tlabcustomaudio/lm4250-replacement/LICENSING.md

# Licensing

| Part | Licence |
|---|---|
| Scripts (`sim/`) | MIT — see `LICENSE` |
| Text, tables, figures (`README.md`, `docs/`, `figures/`, `data/`) | CC BY 4.0 — https://creativecommons.org/licenses/by/4.0/ |
| Hardware (`hardware/`: KiCad schematic, PDF) | CERN-OHL-S-2.0 — https://ohwr.org/cern_ohl_s_v2.txt |

Third-party material (TI/National LM4250 datasheet and AN-71, HGSemi LM13700 datasheet) is not included; refer to the manufacturers.
