tlabcustomaudio/lm4250-replacement/hardware/clone/LM4250_CLONE-schematic.pdf

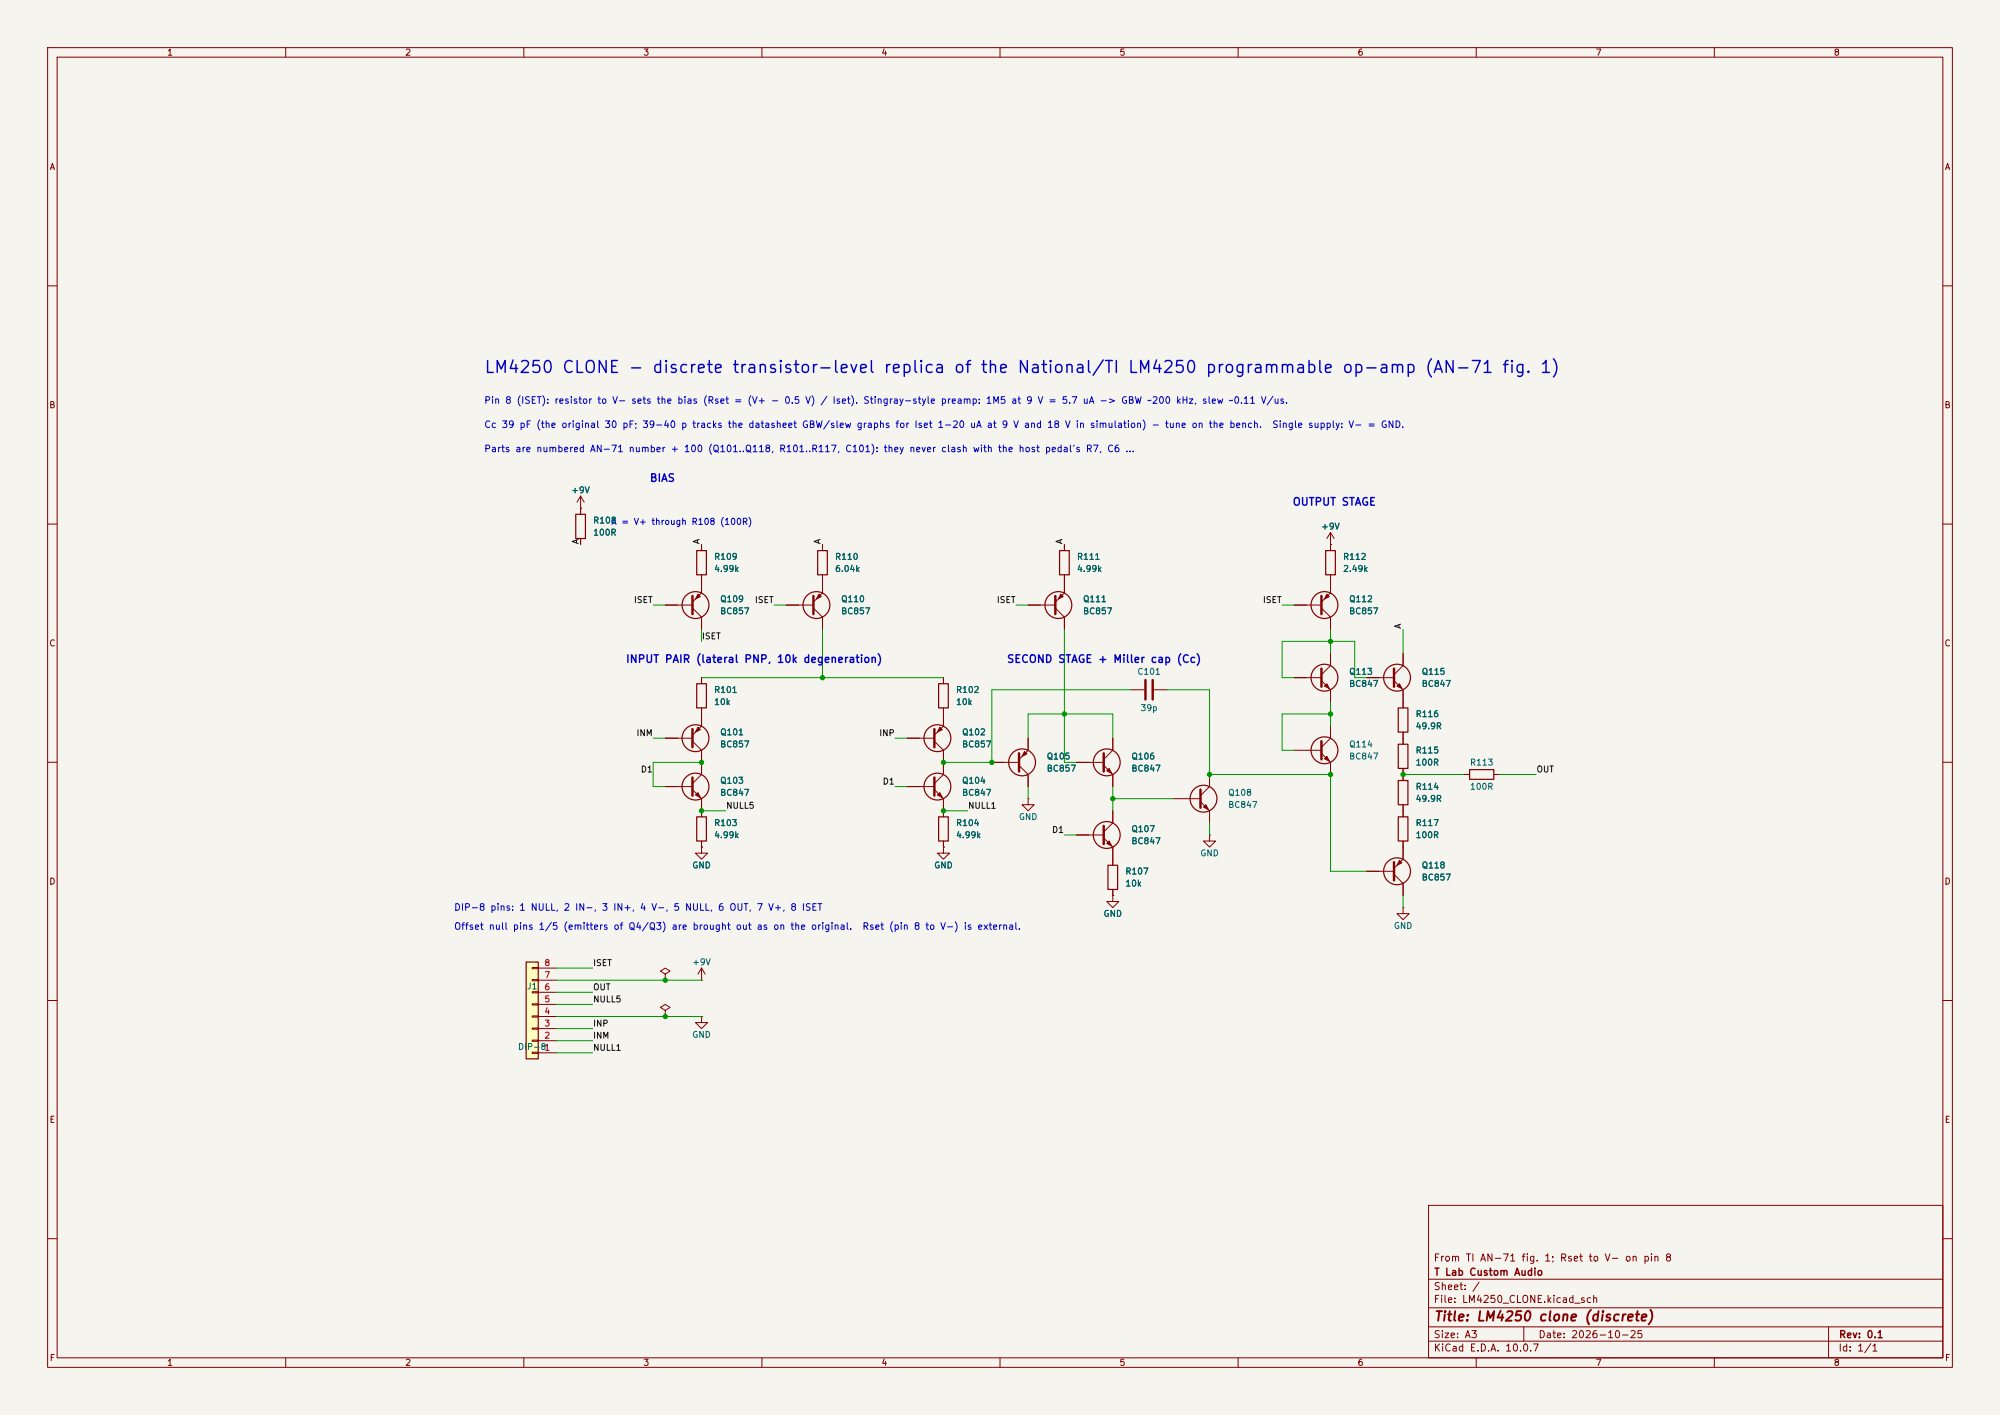
[picture p10: page 1]

LM4250 CLONE - discrete transistor-level replica of the National/TI LM4250 programmable op-amp (AN-71 fig. 1)

A = V+ through R108 (100R) Cc 39 pF (the original 30 pF; 39-40 p tracks the datasheet GBW/slew graphs for Iset 1-20 uA at 9 V and 18 V in simulation) - tune on the bench. Single supply: V- = GND. Parts are numbered AN-71 number + 100 (Q101..Q118, R101..R117, C101): they never clash with the host pedal's R7, C6 ... SECOND STAGE + Miller cap (Cc) Pin 8 (ISET): resistor to V- sets the bias (Rset = (V+ - 0.5 V) / Iset). Stingray-style preamp: 1M5 at 9 V = 5.7 uA -> GBW ~200 kHz, slew ~0.11 V/us.

From TI AN-71 fig. 1; Rset to V- on pin 8
T Lab Custom Audio
Sheet: /
File: LM4250_CLONE.kicad_sch
Title: LM4250 clone (discrete)

Size: A3 | Rev: 0.1 | F Date: 2026-10-25
KiCad E.D.A. 10.0.7 | Id: 1/1
