tlabcustomaudio/lm4250-replacement/hardware/opa333-module/OPA333_MODULE-schematic.pdf

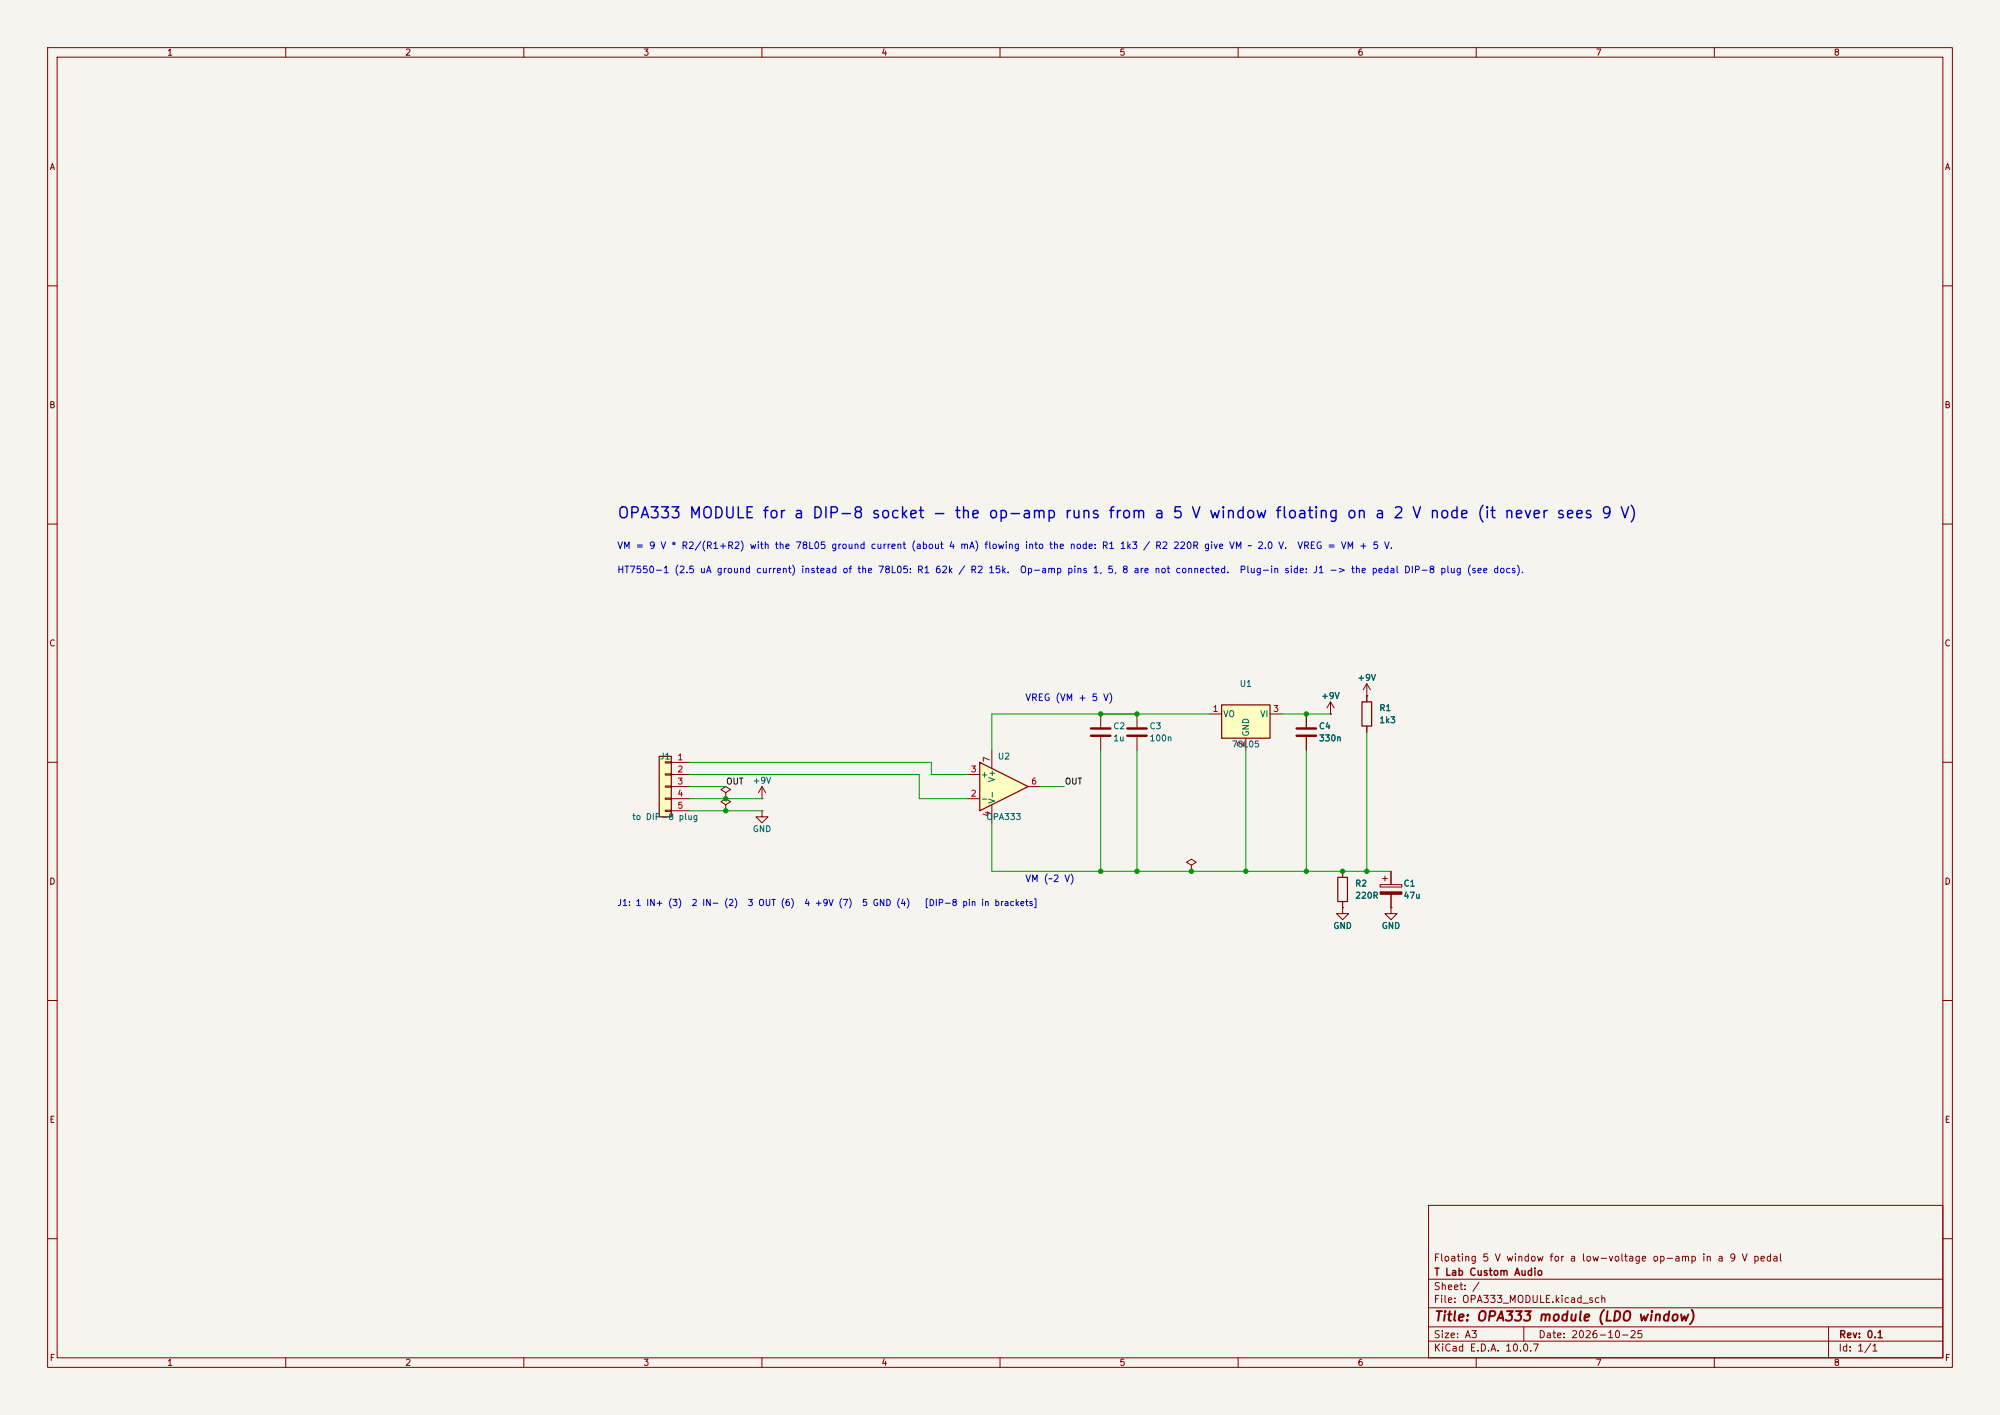
[picture p11: page 1]

Floating 5 V window for a low-voltage op-amp in a 9 V pedal
T Lab Custom Audio
Sheet: /
File: OPA333_MODULE.kicad_sch
Title: OPA333 module (LDO window)

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
