tlabcustomaudio/lm4250-replacement/hardware/clone/LM4250_CLONE.kicad_sch

## KiCad design hardware/clone/LM4250_CLONE.kicad_sch (2026-11-12)

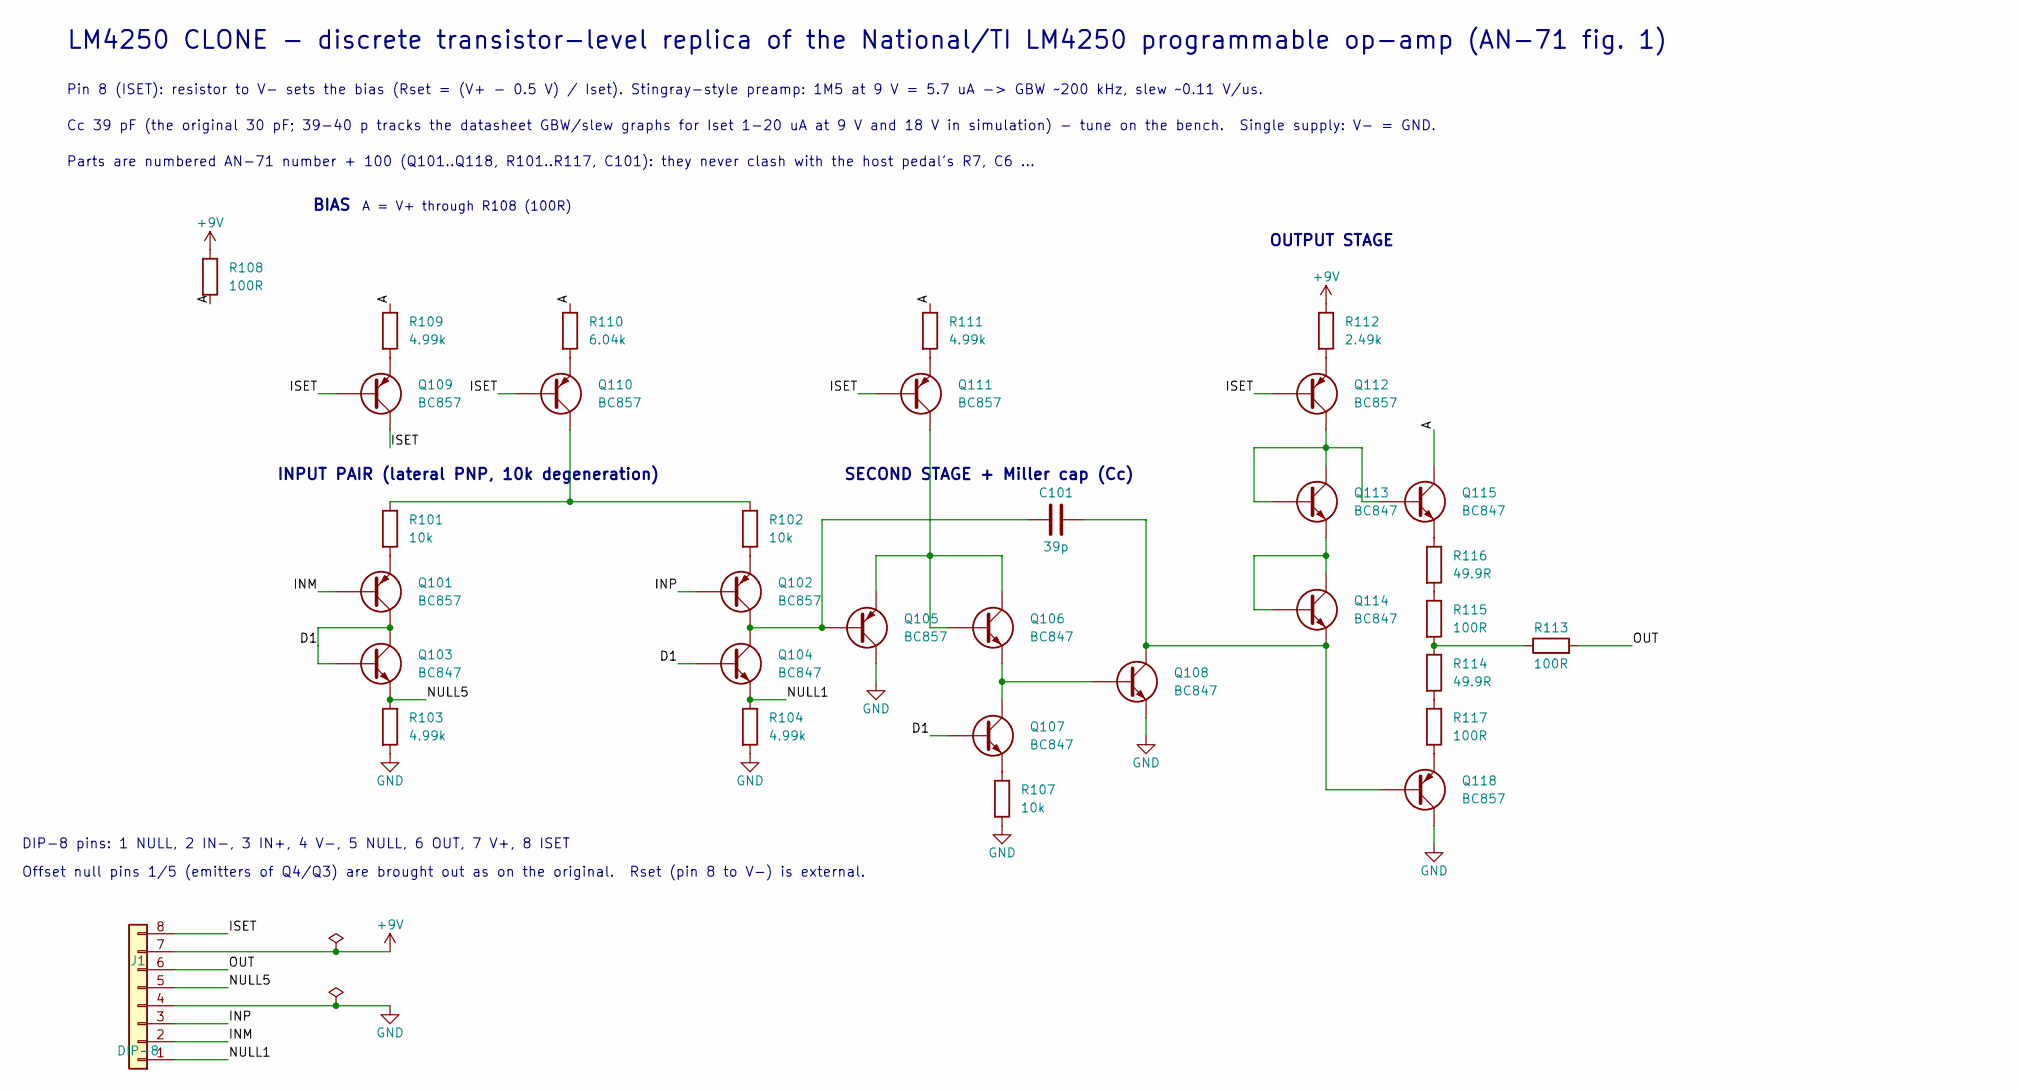
[picture p12: schematic LM4250_CLONE.kicad_sch]

Parts:
C101: 39p
J1: DIP-8
Q101, Q102, Q105, Q109, Q110, Q111, Q112, Q118: BC857
Q103, Q104, Q106, Q107, Q108, Q113, Q114, Q115: BC847
R101, R102, R107: 10k
R103, R104, R109, R111: 4.99k
R108, R113, R115, R117: 100R
R110: 6.04k
R112: 2.49k
R114, R116: 49.9R

Connections:
+9V: J1.7, R108.1, R112.1
A: Q115.C, R108.2, R109.1, R110.1, R111.1
D1: Q101.C, Q103.B, Q103.C, Q104.B, Q107.B
GND: J1.4, Q105.C, Q108.E, Q118.C, R103.2, R104.2, R107.2
INM: J1.2, Q101.B
INP: J1.3, Q102.B
ISET: J1.8, Q109.B, Q109.C, Q110.B, Q111.B, Q112.B
NULL1: J1.1, Q104.E, R104.1
NULL5: J1.5, Q103.E, R103.1
unnamed: C101.1, Q102.C, Q104.C, Q105.B
unnamed: C101.2, Q108.C, Q114.E, Q118.B
unnamed: Q101.E, R101.2
unnamed: Q102.E, R102.2
unnamed: Q105.E, Q106.B, Q106.C, Q111.C
unnamed: Q106.E, Q107.C, Q108.B
unnamed: Q107.E, R107.1
unnamed: Q109.E, R109.2
unnamed: Q110.C, R101.1, R102.1
unnamed: Q110.E, R110.2
unnamed: Q111.E, R111.2
unnamed: Q112.C, Q113.B, Q113.C, Q115.B
unnamed: Q112.E, R112.2
unnamed: Q113.E, Q114.B, Q114.C
unnamed: Q115.E, R116.1
unnamed: Q118.E, R117.2
unnamed: R113.1, R114.1, R115.2
unnamed: R114.2, R117.1
unnamed: R115.1, R116.2
OUT: J1.6, R113.2

Notes on the sheet:
LM4250 CLONE - discrete transistor-level replica of the National/TI LM4250 programmable op-amp (AN-71 fig. 1)
Pin 8 (ISET): resistor to V- sets the bias (Rset = (V+ - 0.5 V) / Iset). Stingray-style preamp: 1M5 at 9 V = 5.7 uA -> GBW ~200 kHz, slew ~0.11 V/us.
Parts are numbered AN-71 number + 100 (Q101..Q118, R101..R117, C101): they never clash with the host pedal's R7, C6 ...
Cc 39 pF (the original 30 pF; 39-40 p tracks the datasheet GBW/slew graphs for Iset 1-20 uA at 9 V and 18 V in simulation) - tune on the bench. Single supply: V- = GND.
A = V+ through R108 (100R)
BIAS
INPUT PAIR (lateral PNP, 10k degeneration)
SECOND STAGE + Miller cap (Cc)
OUTPUT STAGE
DIP-8 pins: 1 NULL, 2 IN-, 3 IN+, 4 V-, 5 NULL, 6 OUT, 7 V+, 8 ISET
Offset null pins 1/5 (emitters of Q4/Q3) are brought out as on the original. Rset (pin 8 to V-) is external.
