tlabcustomaudio/lm4250-replacement/hardware/opa333-module/OPA333_MODULE.kicad_sch

## KiCad design hardware/opa333-module/OPA333_MODULE.kicad_sch (2026-11-12)

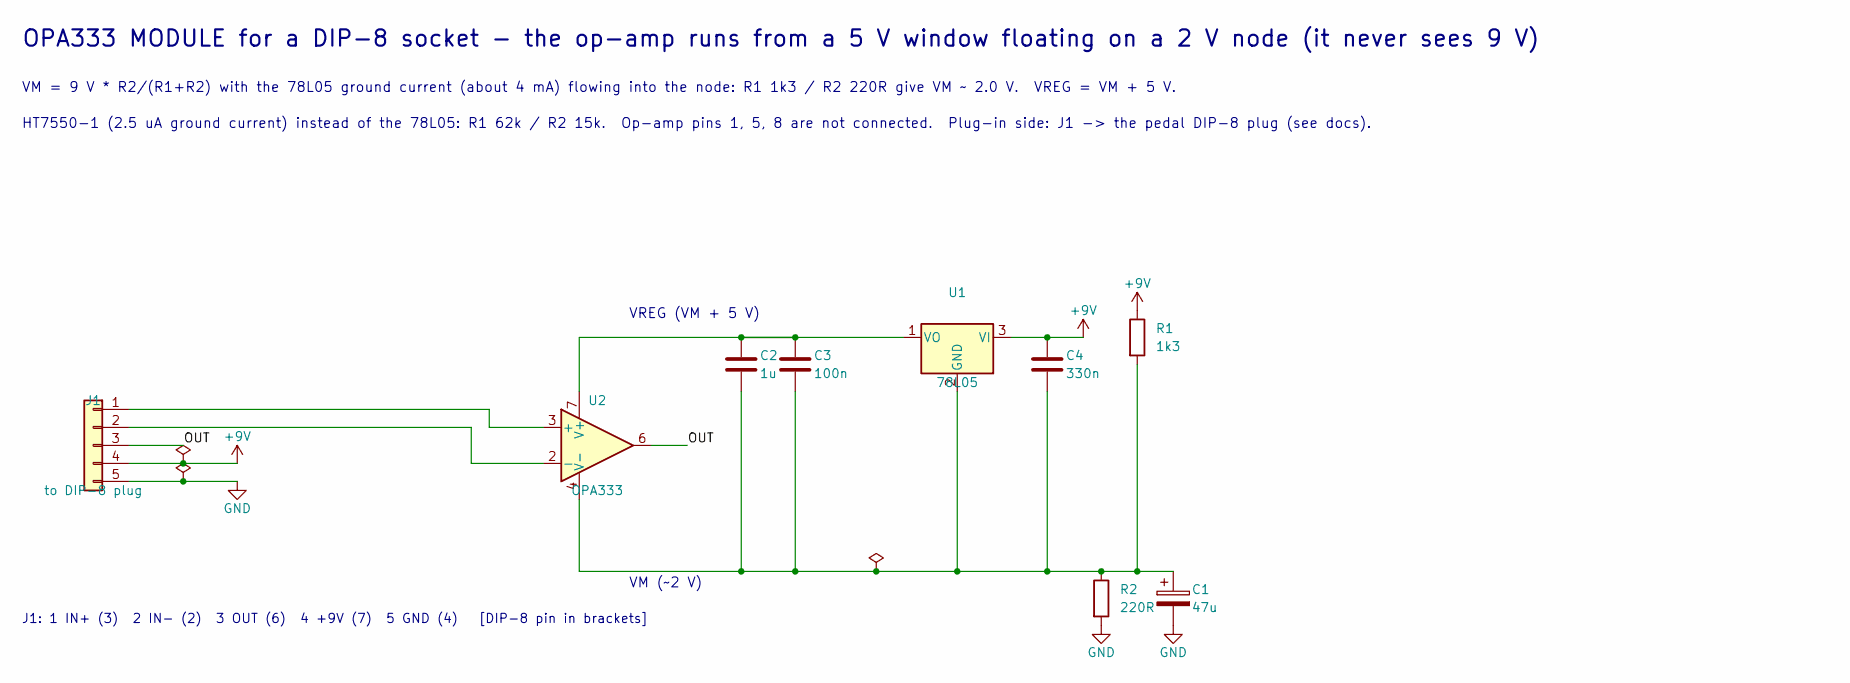
[picture p13: schematic OPA333_MODULE.kicad_sch]

Parts:
C1: 47u
C2: 1u
C3: 100n
C4: 330n
J1: to DIP-8 plug
R1: 1k3
R2: 220R
U1: 78L05
U2: OPA333

Connections:
+9V: C4.1, J1.4, R1.1, U1.3 (VI)
GND: C1.2, J1.5, R2.2
unnamed: C1.1, C2.2, C3.2, C4.2, R1.2, R2.1, U1.2 (GND), U2.4 (V-)
unnamed: C2.1, C3.1, U1.1 (VO), U2.7 (V+)
unnamed: J1.1, U2.3 (+)
unnamed: J1.2, U2.2 (-)
OUT: J1.3, U2.6

Notes on the sheet:
OPA333 MODULE for a DIP-8 socket - the op-amp runs from a 5 V window floating on a 2 V node (it never sees 9 V)
VM = 9 V * R2/(R1+R2) with the 78L05 ground current (about 4 mA) flowing into the node: R1 1k3 / R2 220R give VM ~ 2.0 V. VREG = VM + 5 V.
HT7550-1 (2.5 uA ground current) instead of the 78L05: R1 62k / R2 15k. Op-amp pins 1, 5, 8 are not connected. Plug-in side: J1 -> the pedal DIP-8 plug (see docs).
J1: 1 IN+ (3) 2 IN- (2) 3 OUT (6) 4 +9V (7) 5 GND (4) [DIP-8 pin in brackets]
VREG (VM + 5 V)
VM (~2 V)
