tlabcustomaudio/lm4250-replacement/(commit log)

2026-11-12 LM4250 replacement: simulations, ranking, clone schematic, breadboard guides (work in progress, experimental phase starting)
    [LM4250_CLONE.kicad_sch]
2026-11-12 OPA333 module: KiCad schematic, stripboard layout and guide; clone schematic centred and not cropped; corrected module consumption/regulator numbers
    [LM4250_CLONE.kicad_sch, OPA333_MODULE.kicad_sch]
